tomvand/cf-deck-carrier/(notices)

Notices in the files:
src/cf-deck-carrier/cf-deck-carrier.kicad_pcb:
Crazyflie 2.0 template by Bitcraze AB (CC-BY 4.0)
